Jmanicom/Dual-Rail-Power-Supply/SPICE/Dual-Rail Power Supply-New.asc

B1: bv; V=WHITE(10000*time)
C1: cap; 1.5µ
C2: cap; 0.1µ
C3: cap; 10µ
C4: cap; 2.2µ
C5: cap; 5.6n
C6: cap; 2.2µ
C7: cap; 10µ
C8: cap; 2.2µ
C9: cap; 10µ
C10: cap; 2.2µ
C11: cap; 10µ
C12: cap; 10µ
C13: cap; 2.2µ
C14: cap; 10µ
C15: cap; 10µ
C16: cap; 220p
C17: cap; 220p
C18: cap; 220p
C19: cap; 220p
CL1: cap; 15p
I1: load; PULSE(-0.1 -0.15 2m 1u 1u 1m)
I2: load; PULSE(0 0.15 2m 1u 1u 1m)
L1: ind; 10µ
R1: res; 70.6k
R2: res; 12.4k
R3: res; 47k
R4: res; 1.2Meg
R5: res; 120k
R6: res; 30.6k
R7: res; 120k
R8: res; 30.6k
R9: res; 30k
R10: res; 10k
R11: res; 5k
R12: res; 10.5k
R13: res; 10k
U1: MAX17577
U2: ADP7182
U3: ADP7102
U4: MAX44243
V1: voltage; SINE(0 1 10k)
VSUPP: voltage; 9; Rser=2
Named nets: VSUPP, 0, FB, -VOUT, -6V, +6V, OUT, IN
.tran 0 4m 1m 16n startup
Maxim/Analog MAX17577 based DC-DC Inverting Converter
 
Negative Rail Design Characteristics: 
VOUT = -6V 
f_SW = 600khz
Analog Devices ADP7182 Negative Linear Regulator
 
R5 and R6 resistor divider provides the ADJ pin with the required voltage for a ~ -6V output
A potentiometer can be placed between R5/R6 for user adjustments
Analog Devices ADP7102 Linear Regulator
Equation for calculating R5/R6 divider is the same as the ADP7182
