Jmanicom/Dual-Rail-Power-Supply/(list of files, drawings)

Other design files:
Schematic_PCB/sch_data.json
