Jmanicom/Dual-Rail-Power-Supply/Schematic_PCB/Dual-Rail Power Supply.kicad_pcb

## KiCad design Schematic_PCB/Dual-Rail Power Supply.kicad_pcb (2026-09-25)

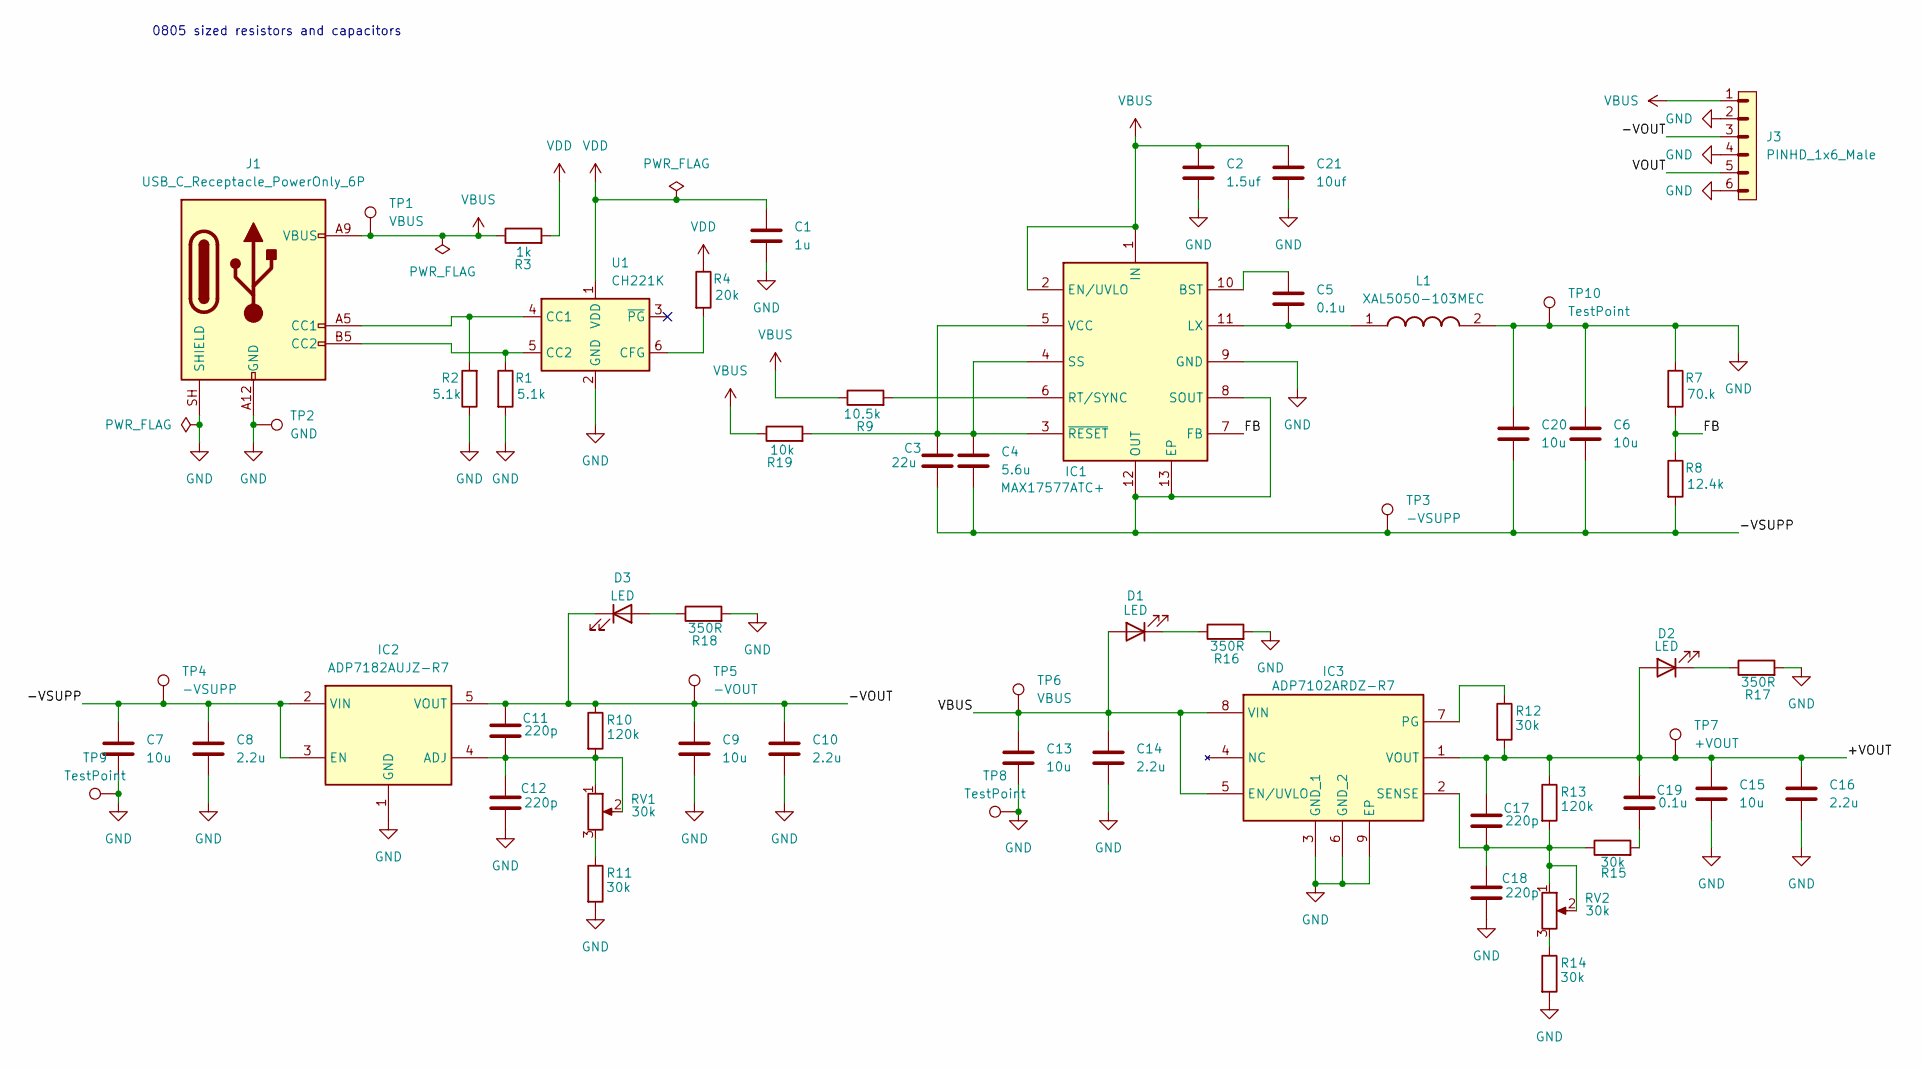
[picture p3: schematic Dual-Rail Power Supply.kicad_sch]

Parts:
C1: 1u; C_0805_2012Metric_Pad1.18x1.45mm_HandSolder
C2: 1.5uf; C_0805_2012Metric_Pad1.18x1.45mm_HandSolder
C3: 22u; C_0805_2012Metric_Pad1.18x1.45mm_HandSolder
C4: 5.6u; C_0805_2012Metric_Pad1.18x1.45mm_HandSolder
C5, C19: 0.1u; C_0603_1608Metric_Pad1.08x0.95mm_HandSolder
C6, C7, C9, C13, C15, C20: 10u; C_1206_3216Metric_Pad1.33x1.80mm_HandSolder
C8, C10, C14, C16: 2.2u; C_0805_2012Metric_Pad1.18x1.45mm_HandSolder
C11, C12, C17, C18: 220p; C_0603_1608Metric_Pad1.08x0.95mm_HandSolder
C21: 10uf; C_0805_2012Metric_Pad1.18x1.45mm_HandSolder
D1, D2, D3: LED; D_0805_2012Metric_Pad1.15x1.40mm_HandSolder
IC1: MAX17577ATC+; Manufacturer_Part_Number MAX17577ATC+; Mouser Part Number 700-MAX17577ATC+
IC2: ADP7182AUJZ-R7; Manufacturer_Part_Number ADP7182AUJZ-R7; Mouser Part Number 584-ADP7182AUJZ-R7
IC3: ADP7102ARDZ-R7; Manufacturer_Part_Number ADP7102ARDZ-R7; Mouser Part Number 584-ADP7102ARDZ-R7
J1: USB_C_Receptacle_PowerOnly_6P; USB_C_Receptacle_GCT_USB4135-GF-A_6P_TopMnt_Horizontal
J3: PINHD_1x6_Male; PinHeader_1x06_P2.54mm_Vertical
L1: XAL5050-103MEC; XEL5050-103MEC; Manufacturer_Part_Number XAL5050-103MEC; Mouser Part Number 994-XAL5050-103MEC
R1, R2: 5.1k; R_0805_2012Metric_Pad1.20x1.40mm_HandSolder
R3: 1k; R_0805_2012Metric_Pad1.20x1.40mm_HandSolder
R4: 20k; R_0805_2012Metric_Pad1.20x1.40mm_HandSolder
R7: 70.k; R_0805_2012Metric_Pad1.20x1.40mm_HandSolder
R8: 12.4k; R_0805_2012Metric_Pad1.20x1.40mm_HandSolder
R9: 10.5k; R_0805_2012Metric_Pad1.20x1.40mm_HandSolder
R10, R13: 120k; R_0805_2012Metric_Pad1.20x1.40mm_HandSolder
R11, R12, R14, R15: 30k; R_0805_2012Metric_Pad1.20x1.40mm_HandSolder
R16, R17, R18: 350R; R_0805_2012Metric_Pad1.20x1.40mm_HandSolder
R19: 10k; R_0805_2012Metric_Pad1.20x1.40mm_HandSolder
RV1, RV2: 30k; Potentiometer_Bourns_TC33X_Vertical
TP1, TP6: VBUS; TestPoint_Pad_D1.5mm
TP2: GND; TestPoint_Pad_D1.5mm
TP3, TP4: -VSUPP; TestPoint_Pad_D1.5mm
TP5: -VOUT; TestPoint_Pad_D1.5mm
TP7: +VOUT; TestPoint_Pad_D1.5mm
TP8, TP9, TP10: TestPoint; TestPoint_Pad_D1.5mm
U1: CH221K; SOT-23-6

Connections:
/+VOUT: C15.1, C16.1, C17.1, C19.1, D2.2 (A), IC3.1 (VOUT), R12.2, R13.1, TP7.1 (1_1)
/-VOUT: C9.1, C10.1, C11.1, D3.1 (K), IC2.5 (VOUT), J3.3, R10.1, TP5.1 (1_1)
/-VSUPP: C3.2, C4.2, C6.2, C7.1, C8.1, C20.2, IC1.8 (SOUT), IC1.12 (OUT), IC1.13 (EP), IC2.2 (VIN), IC2.3 (EN), R8.2, TP3.1 (1_1), TP4.1 (1_1)
/FB: IC1.7 (FB), R7.2, R8.1
/VOUT: J3.5
GND: C1.2, C2.2, C6.1, C7.2, C8.2, C9.2, C10.2, C12.2, C13.2, C14.2, C15.2, C16.2, C18.2, C20.1, C21.2, IC1.9 (GND), IC2.1 (GND), IC3.3 (GND_1), IC3.6 (GND_2), IC3.9 (EP), J1.A12 (GND), J1.B12 (GND), J1.SH (SHIELD), J3.2, J3.4, J3.6, L1.2, R1.2, R2.1, R7.1, R11.2, R14.2, R16.2, R17.2, R18.2, TP2.1 (1_1), TP8.1 (1_1), TP9.1 (1_1), TP10.1 (1_1), U1.2 (GND)
unnamed: C19.2, R15.2
unnamed: D1.1 (K), R16.1
unnamed: D2.1 (K), R17.1
unnamed: D3.2 (A), R18.1
unnamed: C5.1, IC1.10 (BST)
unnamed: C5.2, IC1.11 (LX), L1.1
unnamed: IC1.6 (RT/SYNC), R9.2
unnamed: C3.1, C4.1, IC1.3 (~RESET), IC1.4 (SS), IC1.5 (VCC), R19.2
unnamed: C11.2, C12.1, IC2.4 (ADJ), R10.2, RV1.1, RV1.2
unnamed: IC3.7 (PG), R12.1
unnamed: C17.2, C18.1, IC3.2 (SENSE), R13.2, R15.1, RV2.1, RV2.2
unnamed: J1.A5 (CC1), R2.2, U1.4 (CC1)
unnamed: J1.B5 (CC2), R1.1, U1.5 (CC2)
unnamed: R11.1, RV1.3
unnamed: R14.1, RV2.3
unnamed: R4.2, U1.6 (CFG)
VBUS: C2.1, C13.1, C14.1, C21.1, D1.2 (A), IC1.1 (IN), IC1.2 (EN/UVLO), IC3.5 (EN/UVLO), IC3.8 (VIN), J1.A9 (VBUS), J1.B9 (VBUS), J3.1, R3.1, R9.1, R19.1, TP1.1 (1_1), TP6.1 (1_1)
VDD: C1.1, R3.2, R4.1, U1.1 (VDD)

Notes on the sheet:
0805 sized resistors and capacitors

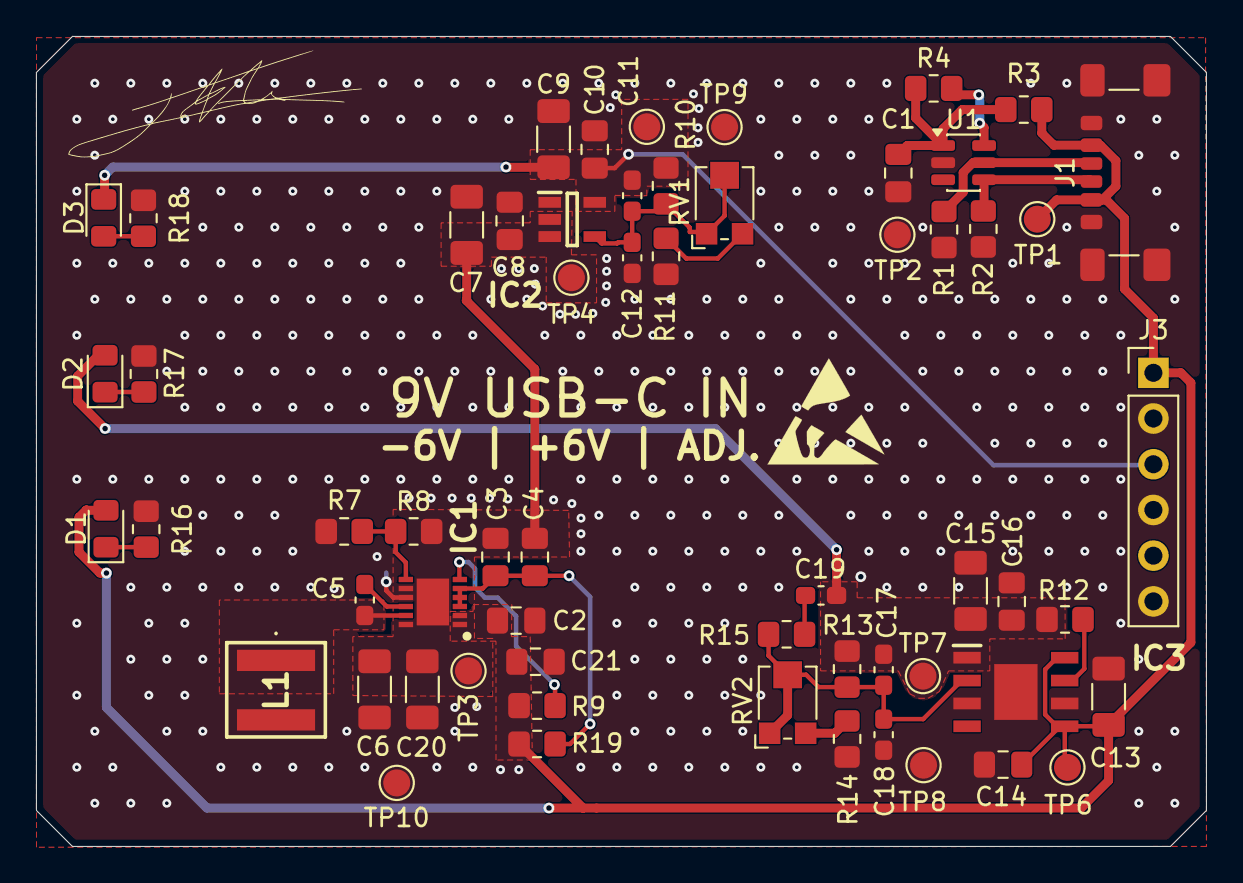
[picture p4: board Dual-Rail Power Supply.kicad_pcb from above]

Board: 4 copper layers, 65.0 x 45.0 mm, 60 parts (0 on the bottom side), 23 nets.
