Jmanicom/Dual-Rail-Power-Supply/(commit log)

2026-09-25 Uploaded Schematic/PCB Files + Media
    [Dual-Rail Power Supply.kicad_pcb, Dual-Rail Power Supply.kicad_sch, sch_data.json]
2026-09-25 Adjust PCB_Back image height in README
    Updated the height of the PCB_Back image in README.
2026-09-25 Adjust PCB_Back image height in README
    Increase height of PCB_Back image in README.
